beyzanrcam/VLSI_ALU_design_sky130b/design/readme

For schematic design

$cd xschem
$xschem

For layout

$cd mag
$magic

For lvs 
$cd netgen
$netgen

https://github.com/Avnish21/VSD-Physical-Verification-Using-Sky130
