beyzanrcam/VLSI_ALU_design_sky130b/design/xschem/alu1.png

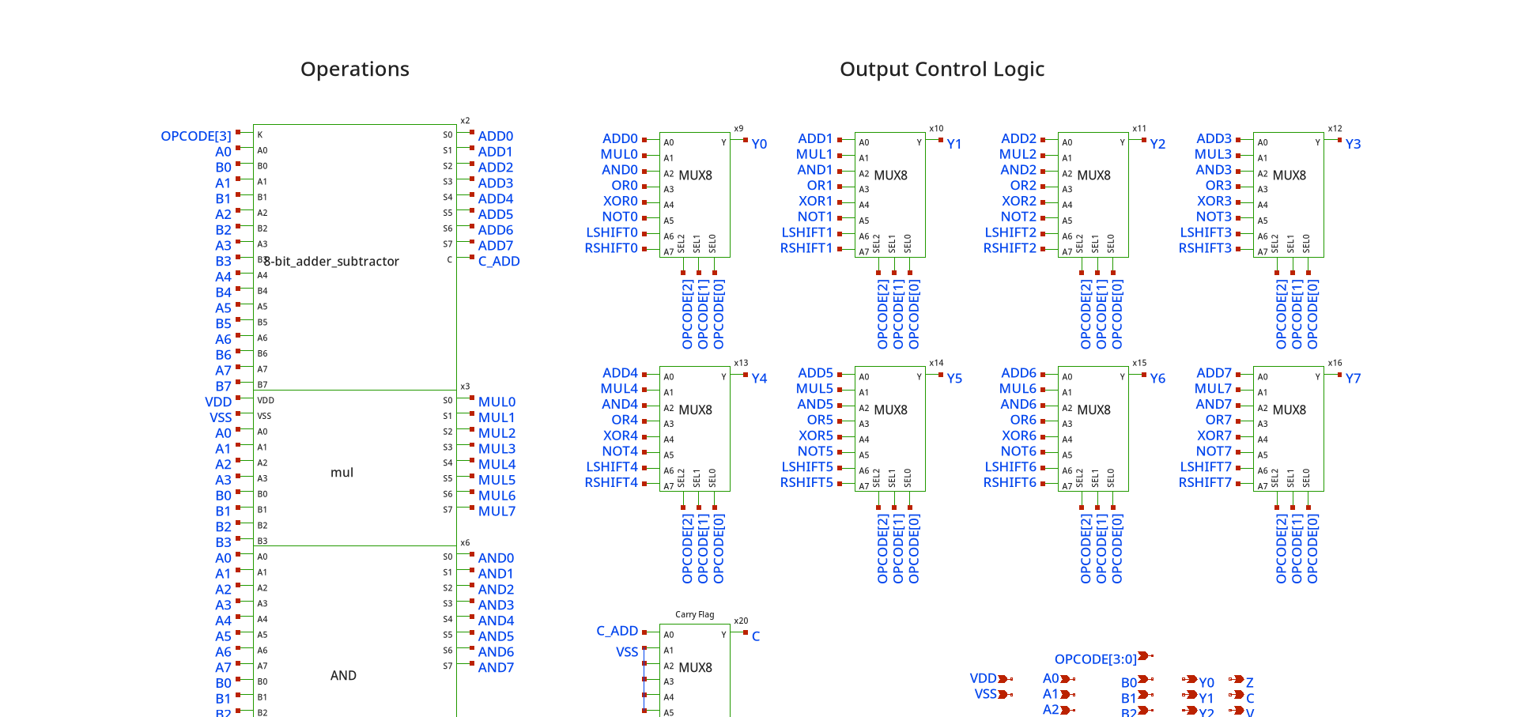
design/xschem/alu1.png
