beyzanrcam/VLSI_ALU_design_sky130b/(commit log)

2024-11-24 inverter schematic and symbol added
    [inv.sch]
2024-11-24 inverter test bench added
    [inv.sch, inv_TB.sch]
2024-11-24 Updated gitignore
    [inv.sch, inv_TB.sch]
2024-11-24 inverter sizing done
    [inv_TB.sch]
2024-11-24 Added Nand Gates
    [nand2.sch, nand3.sch, nand4.sch, nand_TB.sch]
2024-11-24 Added NOR and moved Stuff
    [inv.sch, inv_TB.sch, nand2.sch, nand3.sch, nand4.sch, nand_TB.sch, nor2.sch, nor3.sch]
2024-11-24 Updated inverters
    [inv.sch, inv_TB.sch]
2024-11-24 Gate sizes adjusted
    [nand2.sch, nand3.sch, nand4.sch, nor2.sch, nor3.sch, nor4.sch]
2024-11-24 Finger update
    [inv.sch, inv_TB.sch, nand2.sch, nand3.sch, nand4.sch, nor2.sch, nor3.sch, nor4.sch]
2024-11-28 XOR, XNOR and MUX added with their sub circuit CG4
    [MUX2.sch, XNOR2.sch, XOR2.sch, cg4.sch]
2024-11-28 Added FETS For nand2
    [XNOR2.sch, XOR2.sch, cg4.sch]
2024-11-29 Nand gate layout done and extracted.
    [MUX2.sch, XNOR2.sch, XOR2.sch, cg4.sch, inv.sch, inv_TB.sch, nand2.sch, nand3.sch]
2024-11-29 Nand3 Almost done
    [nand_TB.sch]
2024-12-02 NOR2 done
    [mux_TB.sch, nand2.sch, nor2.sch, nor2_TB.sch, nor2_TB_magic.sch, nor3.sch, pseudo_nand2_tb.sch]
2024-12-02 Spiced it up!
    extracted all the spice files for nands
    [inv_TB.sch, nand_TB.sch]
2024-12-02 NOR4 added (not completed)
    [nor3.sch, nor3_TB.sch, nor3_TB_magic.sch, nor4.sch]
2024-12-02 XOR, XNOR, MUX and their subcir CG4 edited / sch and sym files
    [MUX2.sch, XNOR2.sch, XOR2.sch, cg4.sch]
2024-12-03 Changed Testbenches
    [inv_TB.sch, nand2_TB.sch, nand3_TB.sch, nand4_TB.sch, nor2_TB.sch, nor3_TB.sch, nor4_TB.sch]
2024-12-03 MUX tb added
    [mux_TB.sch]
2024-12-03 NOR4 done
    [nor2_TB.sch, nor3_TB.sch, nor4_TB.sch]
2024-12-04 Updated Testbenches
    [nand2_TB.sch, nand3_TB.sch, nand4.sch, nand4_TB.sch, nor3.sch, nor4.sch]
2024-12-15 NOR3 fixed, alu systemverilog code added
    [nor2.sch, nor2_TB.sch]
2024-12-15 ııııııı
    [hw-4.sch]
2024-12-15 8bit adder schematic
    [8-bit_adder.sch, XOR2.sch, full_adder.sch]
2024-12-15 xor added
    [XOR2.sch]
2024-12-21 Added subtractor and fix nor2
    [8-bit_adder.sch, full_adder.sch, opcodemux.sch, subtractor.sch]
2024-12-21 adder, substractor paths fixed, xor updated
    [8-bit_adder.sch, full_adder.sch, opcodemux.sch, subtractor.sch]
2024-12-21 All RTL schematics generated for each instruction
2024-12-26 left and right shifter done, buffer updated
    [buffer.sch, left_shift.sch, left_shift_.sch]
2024-12-28 not8 layout and schematic
    [not8.sch]
2024-12-28 adder substractor xor nor nand shematics are added
    [8-bit_adder_subtractor.sch, nand_8_bitwise.sch, nor_8_bitwise.sch, subtractor.sch, xor_8_bitwise.sch]
2024-12-28 multiplier xschem not completed
    [half_adder.sch, multiplier.sch]
2024-12-30 Update all bulk connections in schematics
    [cg4.sch, inv.sch, nand2.sch, nand3.sch, nand4.sch, nor2.sch, nor3.sch, nor4.sch]
2024-12-30 inv, buffer, left_shift, right_shift updated
    [buffer_tb.sch, left_shift.sch, left_shift_.sch, left_shifter.sch, pseudo_nand2_tb.sch, right_shifter.sch]
2024-12-30 Fixed some problems with Bulk Migration
    [cg4.sch, nand2.sch, nand3.sch, nand4.sch, nor2.sch, nor3.sch, nor4.sch]
2024-12-30 left_shifter lvs test done
    [inv.sch, left_shifter.sch]
2024-12-31 right_shifter lvs test done
    [right_shifter.sch]
2025-01-02 multiplier xschem is completed
    [multiplier.sch]
2025-01-02 multiplier symbol
    [multiplier.sch]
2025-01-02 not8_sym and not8.spice added
    [multiplier.sch, not8.sch]
2025-01-03 multiplier path issues fixed
    [MUX2.sch, XNOR2.sch, XOR2.sch, multiplier.sch, mux_TB.sch]
2025-01-03 nand8 on progress
    [AND.sch, and_8_bitwise.sch, nand_8_bitwise.sch]
2025-01-03 nand3 updates
    [nand3.sch]
2025-01-04 lvc of nand is completed but lvs of and gives error
    [nand2.sch, nand_8_bitwise.sch]
2025-01-04 AND LVS done, OR started
    [AND.sch, OR8.sch]
2025-01-04 Or8 very close to done (lvs issue)
    [OR8.sch]
2025-01-04 NOR2 fixed, passes lvs
    [nor2.sch, nor2_TB.sch]
2025-01-04 NOR4 lvs done
    [nor3.sch, nor4.sch]
2025-01-04 nor8 and lvs test done
    [nor8.sch]
2025-01-04 removed vdd vss port from nor8 sch
    [nor8.sch]
2025-01-05 Basic gates DONE including LVS
    [OR8.sch, not8.sch]
2025-01-05 Z flag is complete
    [4-bit_adder.sch, AND.sch, V_FLAG.sch, XOR2.sch, Z_FLAG.sch, and2.sch, and_8_bitwise.sch, mul.sch]
2025-01-05 Some symbols added
    [MUX8.sch, alu.sch, xor_8_bitwise.sch]
2025-01-05 multiplier symbol fixed
    [mul.sch]
2025-01-05 decoder sch finished and nand4 fixed.
    [decoder.sch]
2025-01-05 XOR Passes LVS
    [XOR2.sch]
2025-01-05 Fixed Full ader SCH
    [full_adder.sch]
2025-01-05 Alu schematic done
    [8-bit_adder_subtractor.sch, alu.sch]
2025-01-05 Some netlist errors fixed
    [8-bit_adder_subtractor.sch, AND.sch, MUX2.sch, V_FLAG.sch, alu.sch, full_adder.sch, xor_8_bitwise.sch]
2025-01-06 Updated Overflow, Added Labels.
    [8-bit_adder.sch, 8-bit_adder_subtractor.sch, alu.sch]
2025-01-06 and8 testbench done
    [and8_tb.sch, tb_adder_substractor.sch, untitled.sch]
2025-01-06 Added Vdd and Vss to all
    [AND.sch, Nand8Tb.sch]
2025-01-06 more test benches are added
    [AND8_TB.sch, LEFTSHIFTER_TB.sch, NAND8_TB.sch, NOR8_TB.sch, NOT8_TB.sch, Nand8Tb.sch, OR8_TB.sch, RIGHTSHIFTER_TB.sch]
2025-01-06 Updated some schema
    [MUX2.sch, Nand8Tb.sch, XNOR2.sch, XOR2.sch]
2025-01-06 Forgot some stuff in the last push
    [8-bit_adder_subtractor.sch, full_adder_TB.sch, subs_adder_TB.sch, tb_adder_substractor.sch]
2025-01-09 changed some stuff
    [8-bit_adder_subtractor.sch, alu.sch, full_adder.sch, full_adder_substractor.sch, left_shifter.sch, right_shifter.sch]
2025-01-09 adder_substractor netlist error fixed
    [full_adder.sch]
2025-01-09 Added another sizing of inverter
    [XOR2.sch, inv_smol.sch]
2025-01-09 8 bit adder substructor lvs done
    [8-bit_adder_subtractor.sch]
2025-01-09 Updated full adder and lvs tests, removed unnecessary files
    [MUX8.sch, V_FLAG.sch, alu.sch, full_adder.sch, full_adder_substractor.sch]
2025-01-09 Started work on mux
    [MUX8.sch, MUX8_TB.sch, Z_FLAG.sch, mux2efe.sch, nor8.sch]
2025-01-10 alu_testbench on progress
    [4-bit_adder.sch, ALU_TB.sch, V_FLAG.sch, Z_FLAG.sch, alu.sch, mul.sch]
2025-01-10 multiplier tb done ALU simulation works but not completed
    [4-bit_adder.sch, 8-bit_adder_subtractor.sch, ALU_TB.sch, AND.sch, LEFTSHIFTER_TB.sch, MULTIPLIER_TB.sch, MUX8_TB.sch, RIGHTSHIFTER_TB.sch]
2025-01-10 MUX8 done.
    [MUX8.sch]
2025-01-10 pins arranged
    [ALU_TB.sch]
2025-01-10 zero flag sch fixed tb added
    [Z_FLAG.sch, Z_FLAG_TB.sch]
2025-01-10 Alu Tb updated
    [ALU_TB.sch, MUX8.sch, V_FLAG.sch]
2025-01-10 ALU_TB works flawlessly and test benches of MUX for each case is done
    [ALU_TB.sch, MUX8_ADD_TB.sch, MUX8_AND_TB.sch, MUX8_LSHIFT_TB.sch, MUX8_MUL_TB.sch, MUX8_NOT_TB.sch, MUX8_OR_TB.sch, MUX8_RSHIFT_TB.sch]
2025-01-10 Z_FLAG fixed, lvs done
    [Z_FLAG.sch]
2025-01-11 XOR8 layout and lvs_check done
    [ALU_TB_ADD.sch, ALU_TB_AND.sch, ALU_TB_LSHIFT.sch, ALU_TB_MULT.sch, ALU_TB_NOT.sch, ALU_TB_OR.sch, ALU_TB_RSHIFT.sch, ALU_TB_XOR.sch]
2025-01-11 Updates on testbences, Alu magic also has updates
    [ALU_TB_AND.sch, OR8.sch]
2025-01-11 OR8 layout and lvs done
    [OR8.sch]
2025-01-11 Updated some stuff for the alu
    [ALU_TB_AND.sch]
2025-01-12 MULT lvs done
    [mul.sch]
2025-01-12 Alu Layout done without v flag, but vflag done
    [V_FLAG.sch, alu.sch]
2025-01-12 OR8 fixed
    [nor_8_bitwise.sch]
2025-01-12 Update Some Alu stuff related to LVS
    [alu.sch]
2025-01-12 Fixed Lvs errors for Alu
    [alu.sch]
2025-01-12 Alu LVS done.
    [alu.sch]
2025-01-14 Did Some final tests.
    [ALUpex_TB_ADD.sch, ALUpex_TB_delay.sch]
